joedinkle/qmk_firmware/keyboards/eyeohdesigns/theboulevard/CaseFiles/blvd-case-bottom.stl

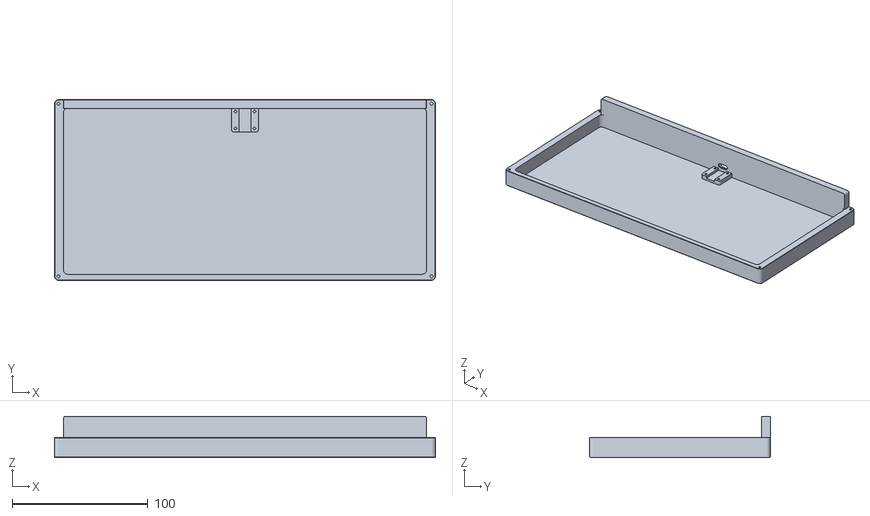
[picture p1: CAD file, 2021-06-13]
keyboards/eyeohdesigns/theboulevard/CaseFiles/blvd-case-bottom.stl
281.2 x 133.4 x 30.6
