joedinkle/qmk_firmware/keyboards/eyeohdesigns/theboulevard/CaseFiles/blvd-top-plate.dxf

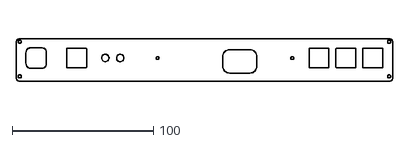
[picture p2: CAD file, 2021-06-13]
keyboards/eyeohdesigns/theboulevard/CaseFiles/blvd-top-plate.dxf
266.1 x 29.7
