joedinkle/qmk_firmware/keyboards/eyeohdesigns/theboulevard/CaseFiles/blvd-case-top.stl

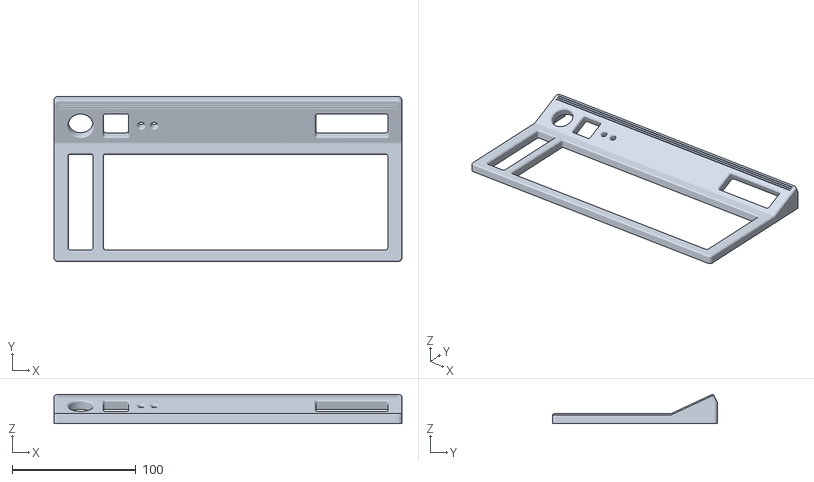
[picture p3: CAD file, 2021-06-13]
keyboards/eyeohdesigns/theboulevard/CaseFiles/blvd-case-top.stl
281.2 x 133.4 x 23.6
