joedinkle/qmk_firmware/keyboards/eyeohdesigns/theboulevard/CaseFiles/blvd-stagger-plate.dxf

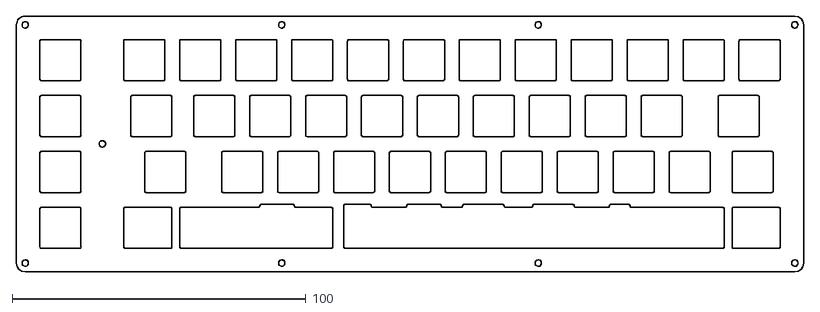
[picture p4: CAD file, 2021-06-13]
keyboards/eyeohdesigns/theboulevard/CaseFiles/blvd-stagger-plate.dxf
268.1 x 87.2
