joedinkle/qmk_firmware/keyboards/eyeohdesigns/theboulevard/CaseFiles/blvd-ortho-plate.dxf

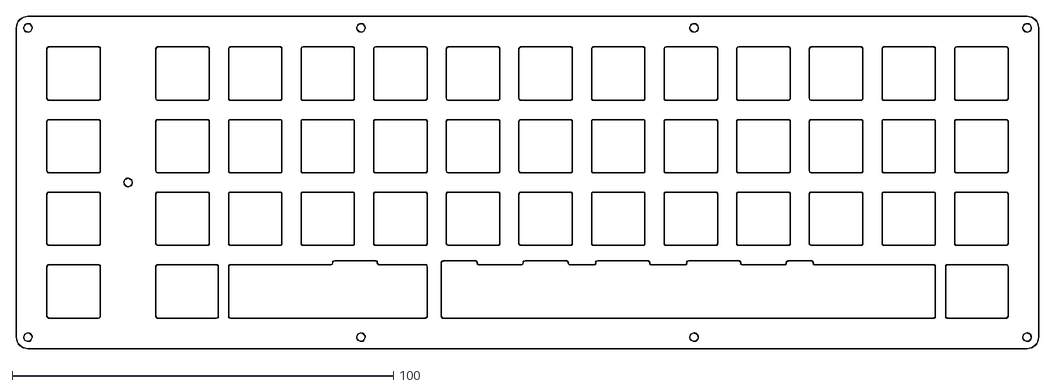
[picture p5: CAD file, 2021-06-13]
keyboards/eyeohdesigns/theboulevard/CaseFiles/blvd-ortho-plate.dxf
268.1 x 87.2
