joedinkle/qmk_firmware/keyboards/eyeohdesigns/theboulevard/PCBFiles/mainpcb/theboulevard.kicad_pcb

## KiCad design keyboards/eyeohdesigns/theboulevard/PCBFiles/mainpcb/theboulevard.kicad_pcb (2021-05-25)

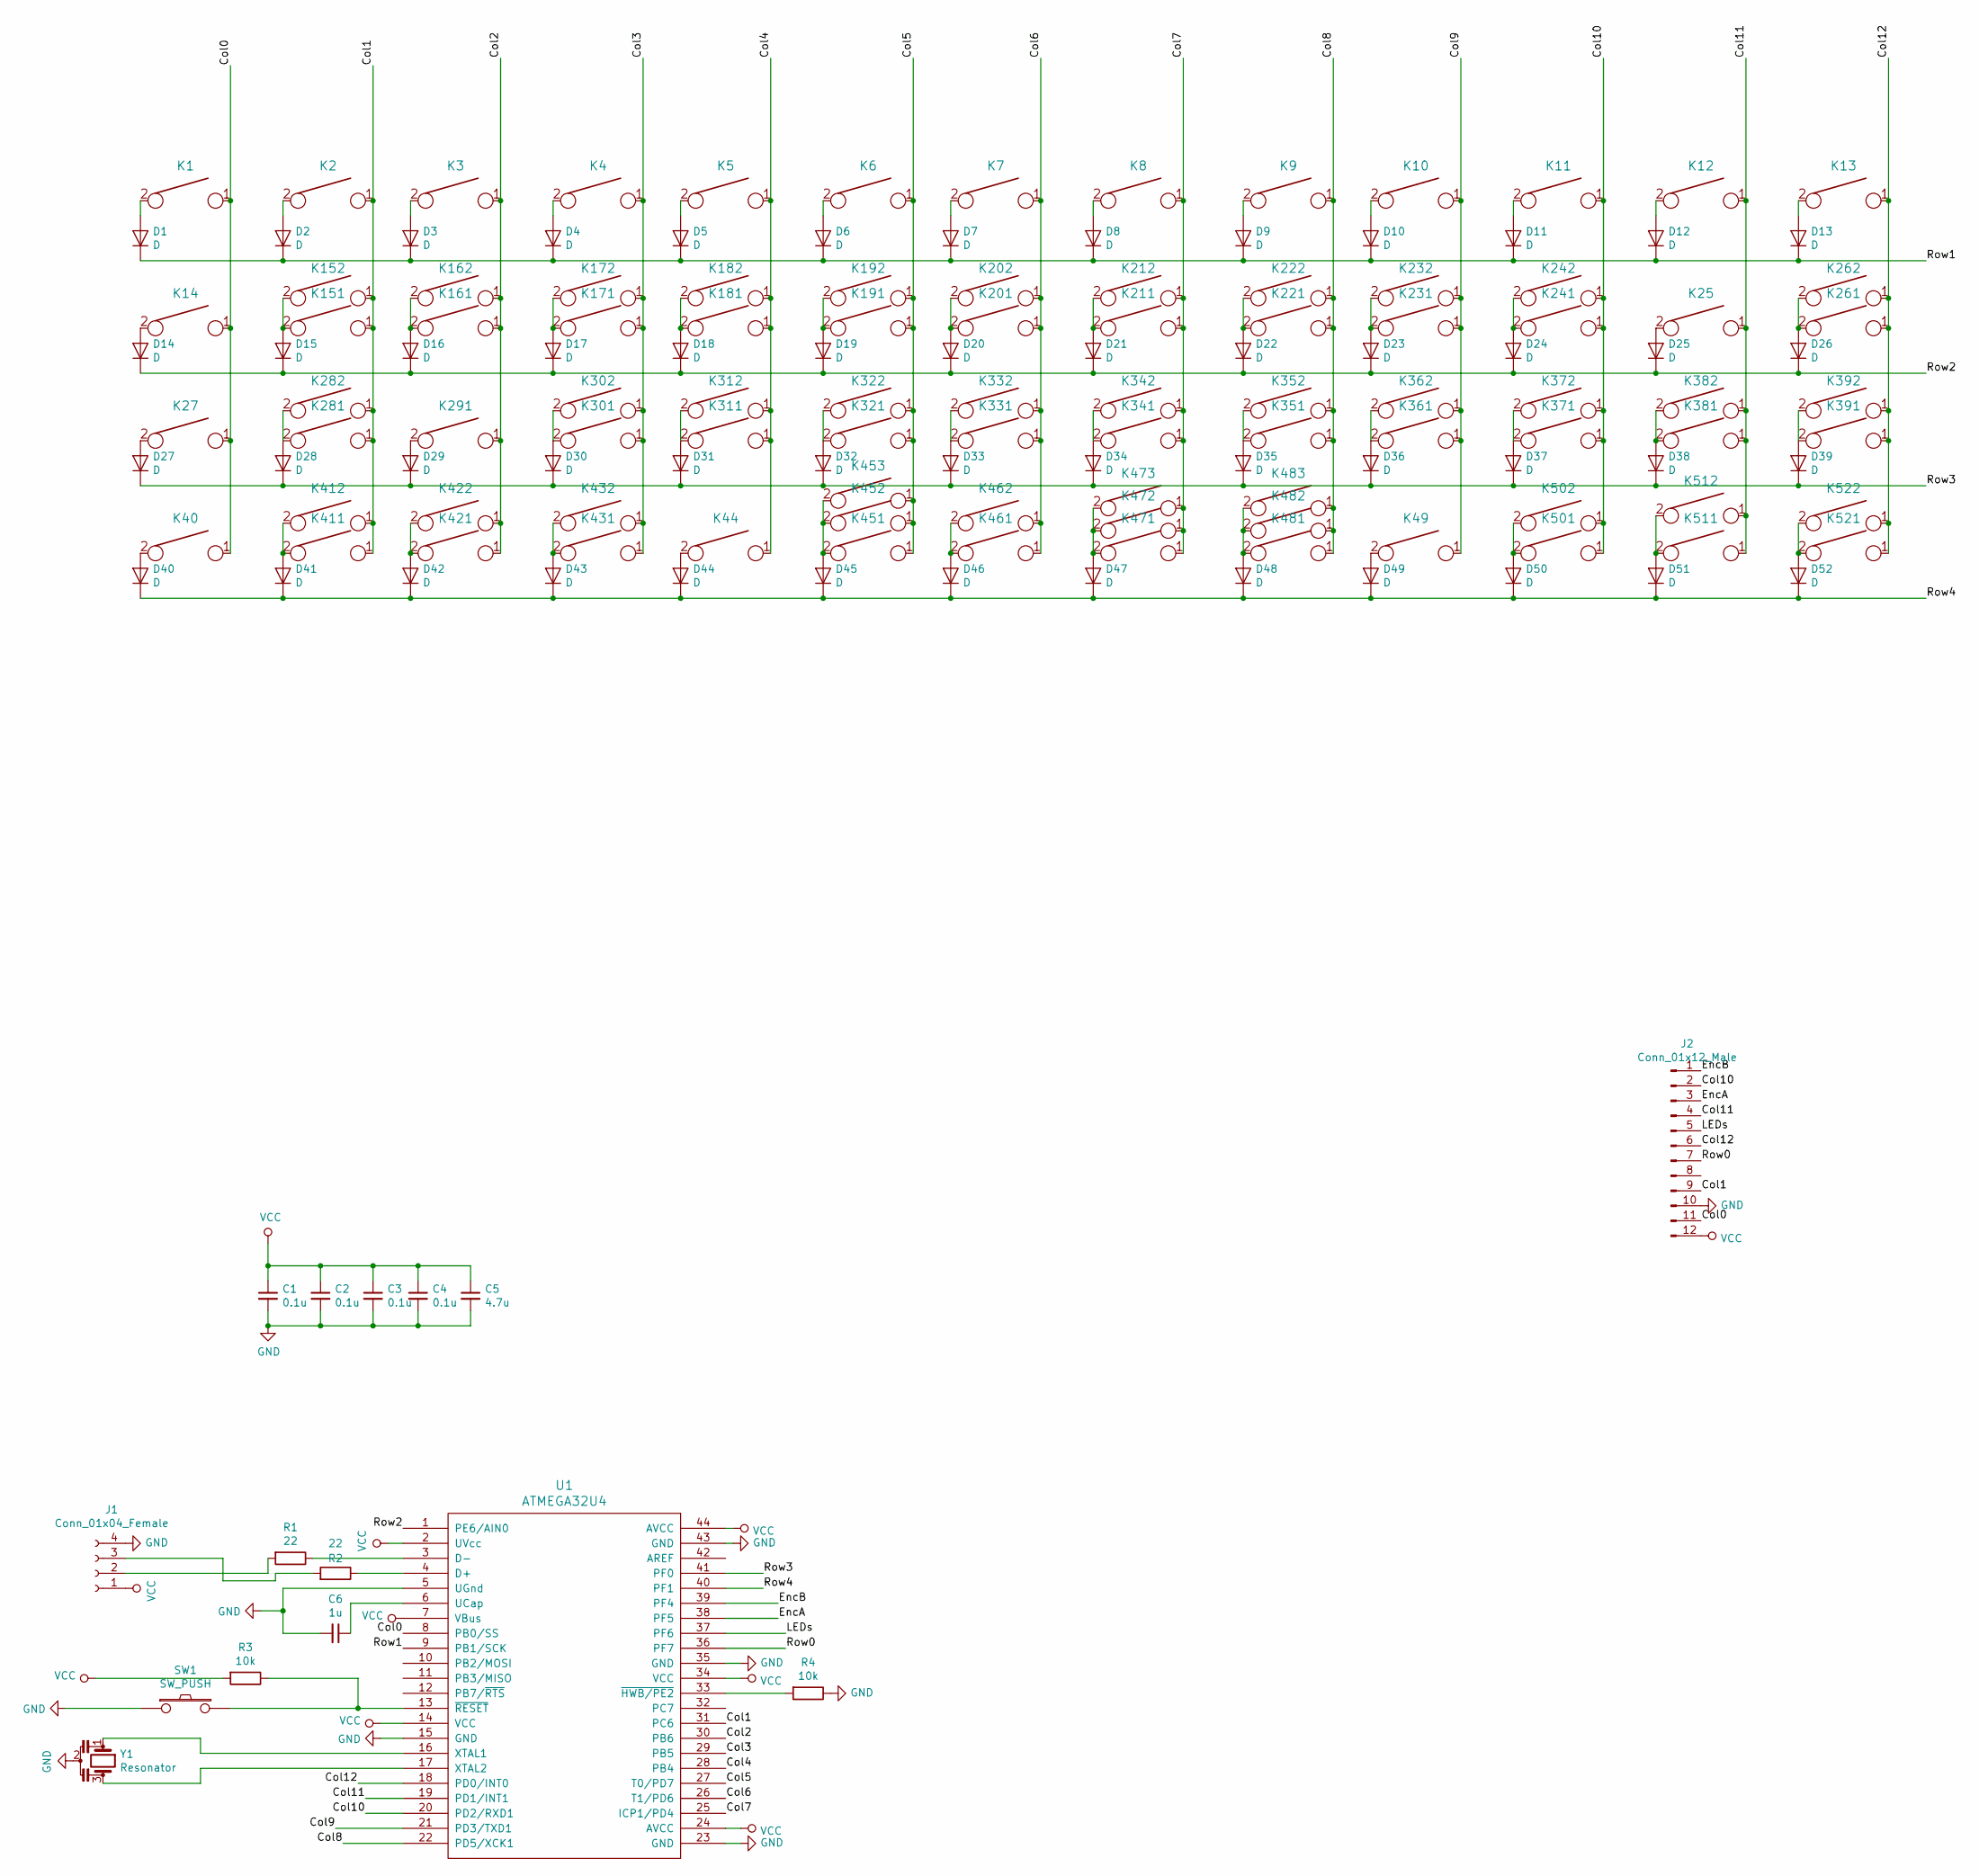
[picture p6: schematic theboulevard.sch]

Parts:
C1, C2, C3, C4: 0.1u; C_0603_1608Metric_Pad1.05x0.95mm_HandSolder
C5: 4.7u; C_0603_1608Metric_Pad1.05x0.95mm_HandSolder
C6: 1u; C_0603_1608Metric_Pad1.05x0.95mm_HandSolder
D1, D2, D3, D4, D5, D6, D7, D8, D9, D10, D11, D12, D13, D14, D15, D16, D17, D18, D19, D20, D21, D22, D23, D24, D25, D26, D27, D28, D29, D30, D31, D32, D33, D34, D35, D36, D37, D38, D39, D40, D41, D42, D43, D44, D45, D46, D47, D48, D49, D50, D51, D52: D; D_SOD123
J1: Conn_01x04_Female; JST_SH_SM04B-SRSS-TB_1x04-1MP_P1.00mm_Horizontal
J2: Conn_01x12_Male; PinHeader_2x06_P2.00mm_Horizontal
K1, K2, K3, K4, K5, K6, K7, K8, K9, K10, K11, K12, K13, K14, K25, K27, K40, K44, K49, K151, K161, K162, K171, K172, K181, K182, K191, K192, K201, K202, K211, K212, K221, K222, K231, K232, K241, K242, K261, K281, K291, K301, K302, K311, K312, K321, K322, K331, K332, K341, K342, K351, K352, K361, K362, K371, K372, K381, K382, K391, K411, K421, K431, K451, K461, K471, K481, K501, K511, K521: KEYSW; SW_Cherry_MX_1.00u_PCB_No_Silk
K152, K392, K412, K432, K502, K522: KEYSW; SW_Cherry_MX_1.25u_PCB_No_Silk
K262, K282: KEYSW; SW_Cherry_MX_1.75u_PCB_No_Silk
K422, K512: KEYSW; SW_Cherry_MX_1.50u_PCB_No_Silk
K452, K473, K483: KEYSW; SW_Cherry_MX_2.00u_PCB_Flip_Stab
K453: KEYSW; MX_2.75u_PCB_No_Silk_Flipped_Stab
K462: KEYSW; MX_6.25u_PCB_Flipped_Stab_No_Silk
K472: KEYSW; SW_Cherry_MX_7u_PCB_No_Silk_Flip_Stab
K482: KEYSW; MX_2.25u_PCB_No_Silk_Flipped_Stab
R1, R2: 22; R_0603_1608Metric_Pad1.05x0.95mm_HandSolder
R3, R4: 10k; R_0603_1608Metric_Pad1.05x0.95mm_HandSolder
SW1: SW_PUSH; SW_SPST_TL3342
U1: ATMEGA32U4; QFN-44-1EP_7x7mm_P0.5mm_EP5.2x5.2mm
Y1: Resonator; Abracon_Resonator_16MHz_22pf

Connections:
/Col0: J2.11, K1.1, K14.1, K27.1, K40.1, U1.8 (PB0/SS)
/Col1: J2.9, K2.1, K151.1, K152.1, K281.1, K282.1, K411.1, K412.1, U1.31 (PC6)
/Col2: K3.1, K161.1, K162.1, K291.1, K421.1, K422.1, U1.30 (PB6)
/Col3: K4.1, K171.1, K172.1, K301.1, K302.1, K431.1, K432.1, U1.29 (PB5)
/Col4: K5.1, K44.1, K181.1, K182.1, K311.1, K312.1, U1.28 (PB4)
/Col5: K6.1, K191.1, K192.1, K321.1, K322.1, K451.1, K452.1, K453.1, U1.27 (T0/PD7)
/Col6: K7.1, K201.1, K202.1, K331.1, K332.1, K461.1, K462.1, U1.26 (T1/PD6)
/Col7: K8.1, K211.1, K212.1, K341.1, K342.1, K471.1, K472.1, K473.1, U1.25 (ICP1/PD4)
/Col8: K9.1, K221.1, K222.1, K351.1, K352.1, K481.1, K482.1, K483.1, U1.22 (PD5/XCK1)
/Col9: K10.1, K49.1, K231.1, K232.1, K361.1, K362.1, U1.21 (PD3/TXD1)
/Col10: J2.2, K11.1, K241.1, K242.1, K371.1, K372.1, K501.1, K502.1, U1.20 (PD2/RXD1)
/Col11: J2.4, K12.1, K25.1, K381.1, K382.1, K511.1, K512.1, U1.19 (PD1/INT1)
/Col12: J2.6, K13.1, K261.1, K262.1, K391.1, K392.1, K521.1, K522.1, U1.18 (PD0/INT0)
/EncA: J2.3, U1.38 (PF5)
/EncB: J2.1, U1.39 (PF4)
/LEDs: J2.5, U1.37 (PF6)
/Row0: J2.7, U1.36 (PF7)
/Row1: D1.1 (K), D2.1 (K), D3.1 (K), D4.1 (K), D5.1 (K), D6.1 (K), D7.1 (K), D8.1 (K), D9.1 (K), D10.1 (K), D11.1 (K), D12.1 (K), D13.1 (K), U1.9 (PB1/SCK)
/Row2: D14.1 (K), D15.1 (K), D16.1 (K), D17.1 (K), D18.1 (K), D19.1 (K), D20.1 (K), D21.1 (K), D22.1 (K), D23.1 (K), D24.1 (K), D25.1 (K), D26.1 (K), U1.1 (PE6/AIN0)
/Row3: D27.1 (K), D28.1 (K), D29.1 (K), D30.1 (K), D31.1 (K), D32.1 (K), D33.1 (K), D34.1 (K), D35.1 (K), D36.1 (K), D37.1 (K), D38.1 (K), D39.1 (K), U1.41 (PF0)
/Row4: D40.1 (K), D41.1 (K), D42.1 (K), D43.1 (K), D44.1 (K), D45.1 (K), D46.1 (K), D47.1 (K), D48.1 (K), D49.1 (K), D50.1 (K), D51.1 (K), D52.1 (K), U1.40 (PF1)
GND: C1.2, C2.2, C3.2, C4.2, C5.2, C6.2, J1.4, J2.10, R4.1, SW1.1, U1.5 (UGnd), U1.15 (GND), U1.23 (GND), U1.35 (GND), U1.43 (GND), Y1.2
unnamed: C6.1, U1.6 (UCap)
unnamed: D1.2 (A), K1.2
unnamed: D2.2 (A), K2.2
unnamed: D3.2 (A), K3.2
unnamed: D4.2 (A), K4.2
unnamed: D5.2 (A), K5.2
unnamed: D6.2 (A), K6.2
unnamed: D7.2 (A), K7.2
unnamed: D8.2 (A), K8.2
unnamed: D9.2 (A), K9.2
unnamed: D10.2 (A), K10.2
unnamed: D11.2 (A), K11.2
unnamed: D12.2 (A), K12.2
unnamed: D13.2 (A), K13.2
unnamed: D14.2 (A), K14.2
unnamed: D15.2 (A), K151.2, K152.2
unnamed: D16.2 (A), K161.2, K162.2
unnamed: D17.2 (A), K171.2, K172.2
unnamed: D18.2 (A), K181.2, K182.2
unnamed: D19.2 (A), K191.2, K192.2
unnamed: D20.2 (A), K201.2, K202.2
unnamed: D21.2 (A), K211.2, K212.2
unnamed: D22.2 (A), K221.2, K222.2
unnamed: D23.2 (A), K231.2, K232.2
unnamed: D24.2 (A), K241.2, K242.2
unnamed: D25.2 (A), K25.2
unnamed: D26.2 (A), K261.2, K262.2
unnamed: D27.2 (A), K27.2
unnamed: D28.2 (A), K281.2, K282.2
unnamed: D29.2 (A), K291.2
unnamed: D30.2 (A), K301.2, K302.2
unnamed: D31.2 (A), K311.2, K312.2
unnamed: D32.2 (A), K321.2, K322.2
unnamed: D33.2 (A), K331.2, K332.2
unnamed: D34.2 (A), K341.2, K342.2
unnamed: D35.2 (A), K351.2, K352.2
unnamed: D36.2 (A), K361.2, K362.2
unnamed: D37.2 (A), K371.2, K372.2
unnamed: D38.2 (A), K381.2, K382.2
unnamed: D39.2 (A), K391.2, K392.2
unnamed: D40.2 (A), K40.2
unnamed: D41.2 (A), K411.2, K412.2
unnamed: D42.2 (A), K421.2, K422.2
unnamed: D43.2 (A), K431.2, K432.2
unnamed: D44.2 (A), K44.2
unnamed: D45.2 (A), K451.2, K452.2, K453.2
unnamed: D46.2 (A), K461.2, K462.2
unnamed: D47.2 (A), K471.2, K472.2, K473.2
unnamed: D48.2 (A), K481.2, K482.2, K483.2
unnamed: D49.2 (A), K49.2
unnamed: D50.2 (A), K501.2, K502.2
unnamed: D51.2 (A), K511.2, K512.2
unnamed: D52.2 (A), K521.2, K522.2
unnamed: J1.2, R1.2
unnamed: J1.3, R2.2
unnamed: R1.1, U1.3 (D-)
unnamed: R2.1, U1.4 (D+)
unnamed: R3.1, SW1.2, U1.13 (~RESET)
unnamed: R4.2, U1.33 (~HWB/PE2)
unnamed: U1.16 (XTAL1), Y1.1
unnamed: U1.17 (XTAL2), Y1.3
VCC: C1.1, C2.1, C3.1, C4.1, C5.1, J1.1, J2.12, R3.2, U1.2 (UVcc), U1.7 (VBus), U1.14 (VCC), U1.24 (AVCC), U1.34 (VCC), U1.44 (AVCC)

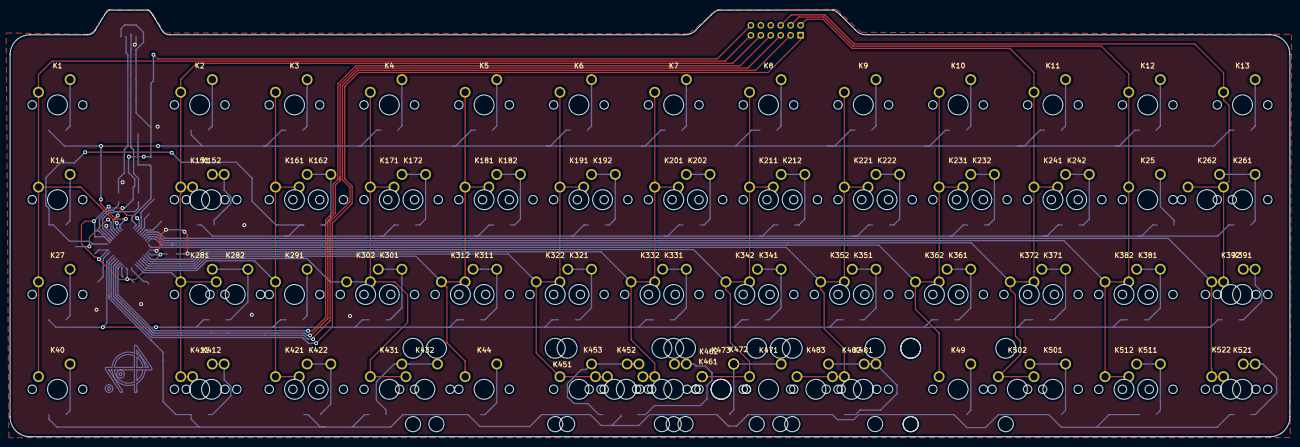
[picture p7: board theboulevard.kicad_pcb from above]

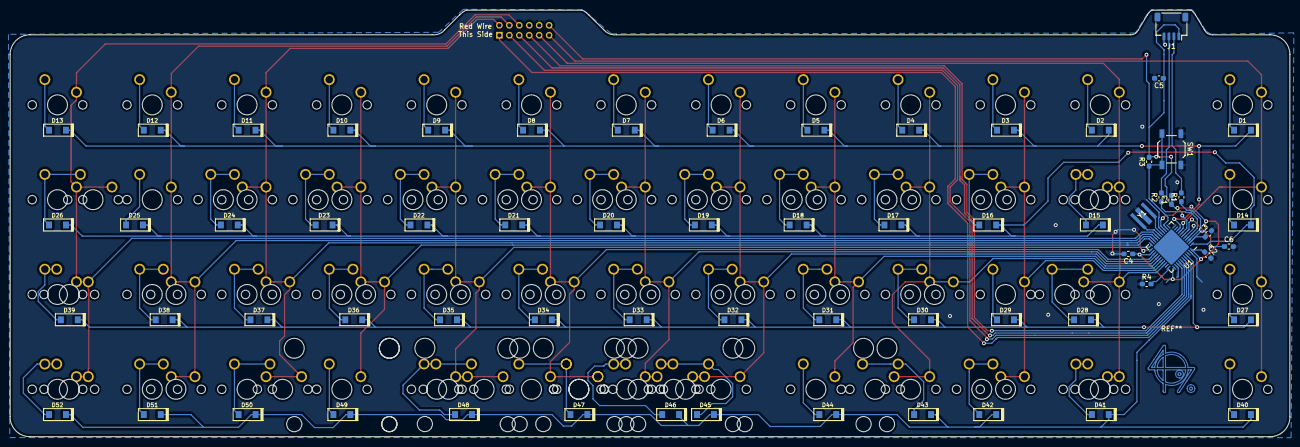
[picture p8: board theboulevard.kicad_pcb from below]

Board: 2 copper layers, 257.2 x 85.7 mm, 154 parts (67 on the bottom side), 84 nets.
