joedinkle/qmk_firmware/(commit log)

2020-12-15 Add SPRH Prototype Test map.
2021-05-25 Fixes a reversed connector on the main PCB
    [theboulevard-B_Cu.gbl, theboulevard-B_Mask.gbs, theboulevard-B_Paste.gbp, theboulevard-B_SilkS.gbo, theboulevard-Edge_Cuts.gm1, theboulevard-F_Cu.gtl, theboulevard-F_Mask.gts, theboulevard-F_Paste.gtp]
2021-06-13 Added case files
    [blvd-case-bottom.stl, blvd-case-top.stl, blvd-ortho-plate.dxf, blvd-stagger-plate.dxf, blvd-top-plate.dxf]
